mimeindustries/mearm-pi-hat-pcb/README.md

## MeArm Raspberry Pi HAT PCB

This repository contains the KiCAD project for the MeArm Raspberry Pi HAT
