mimeindustries/mearm-pi-hat-pcb/MeArmPiHat.kicad_pcb

## KiCad design MeArmPiHat.kicad_pcb (2017-10-23)

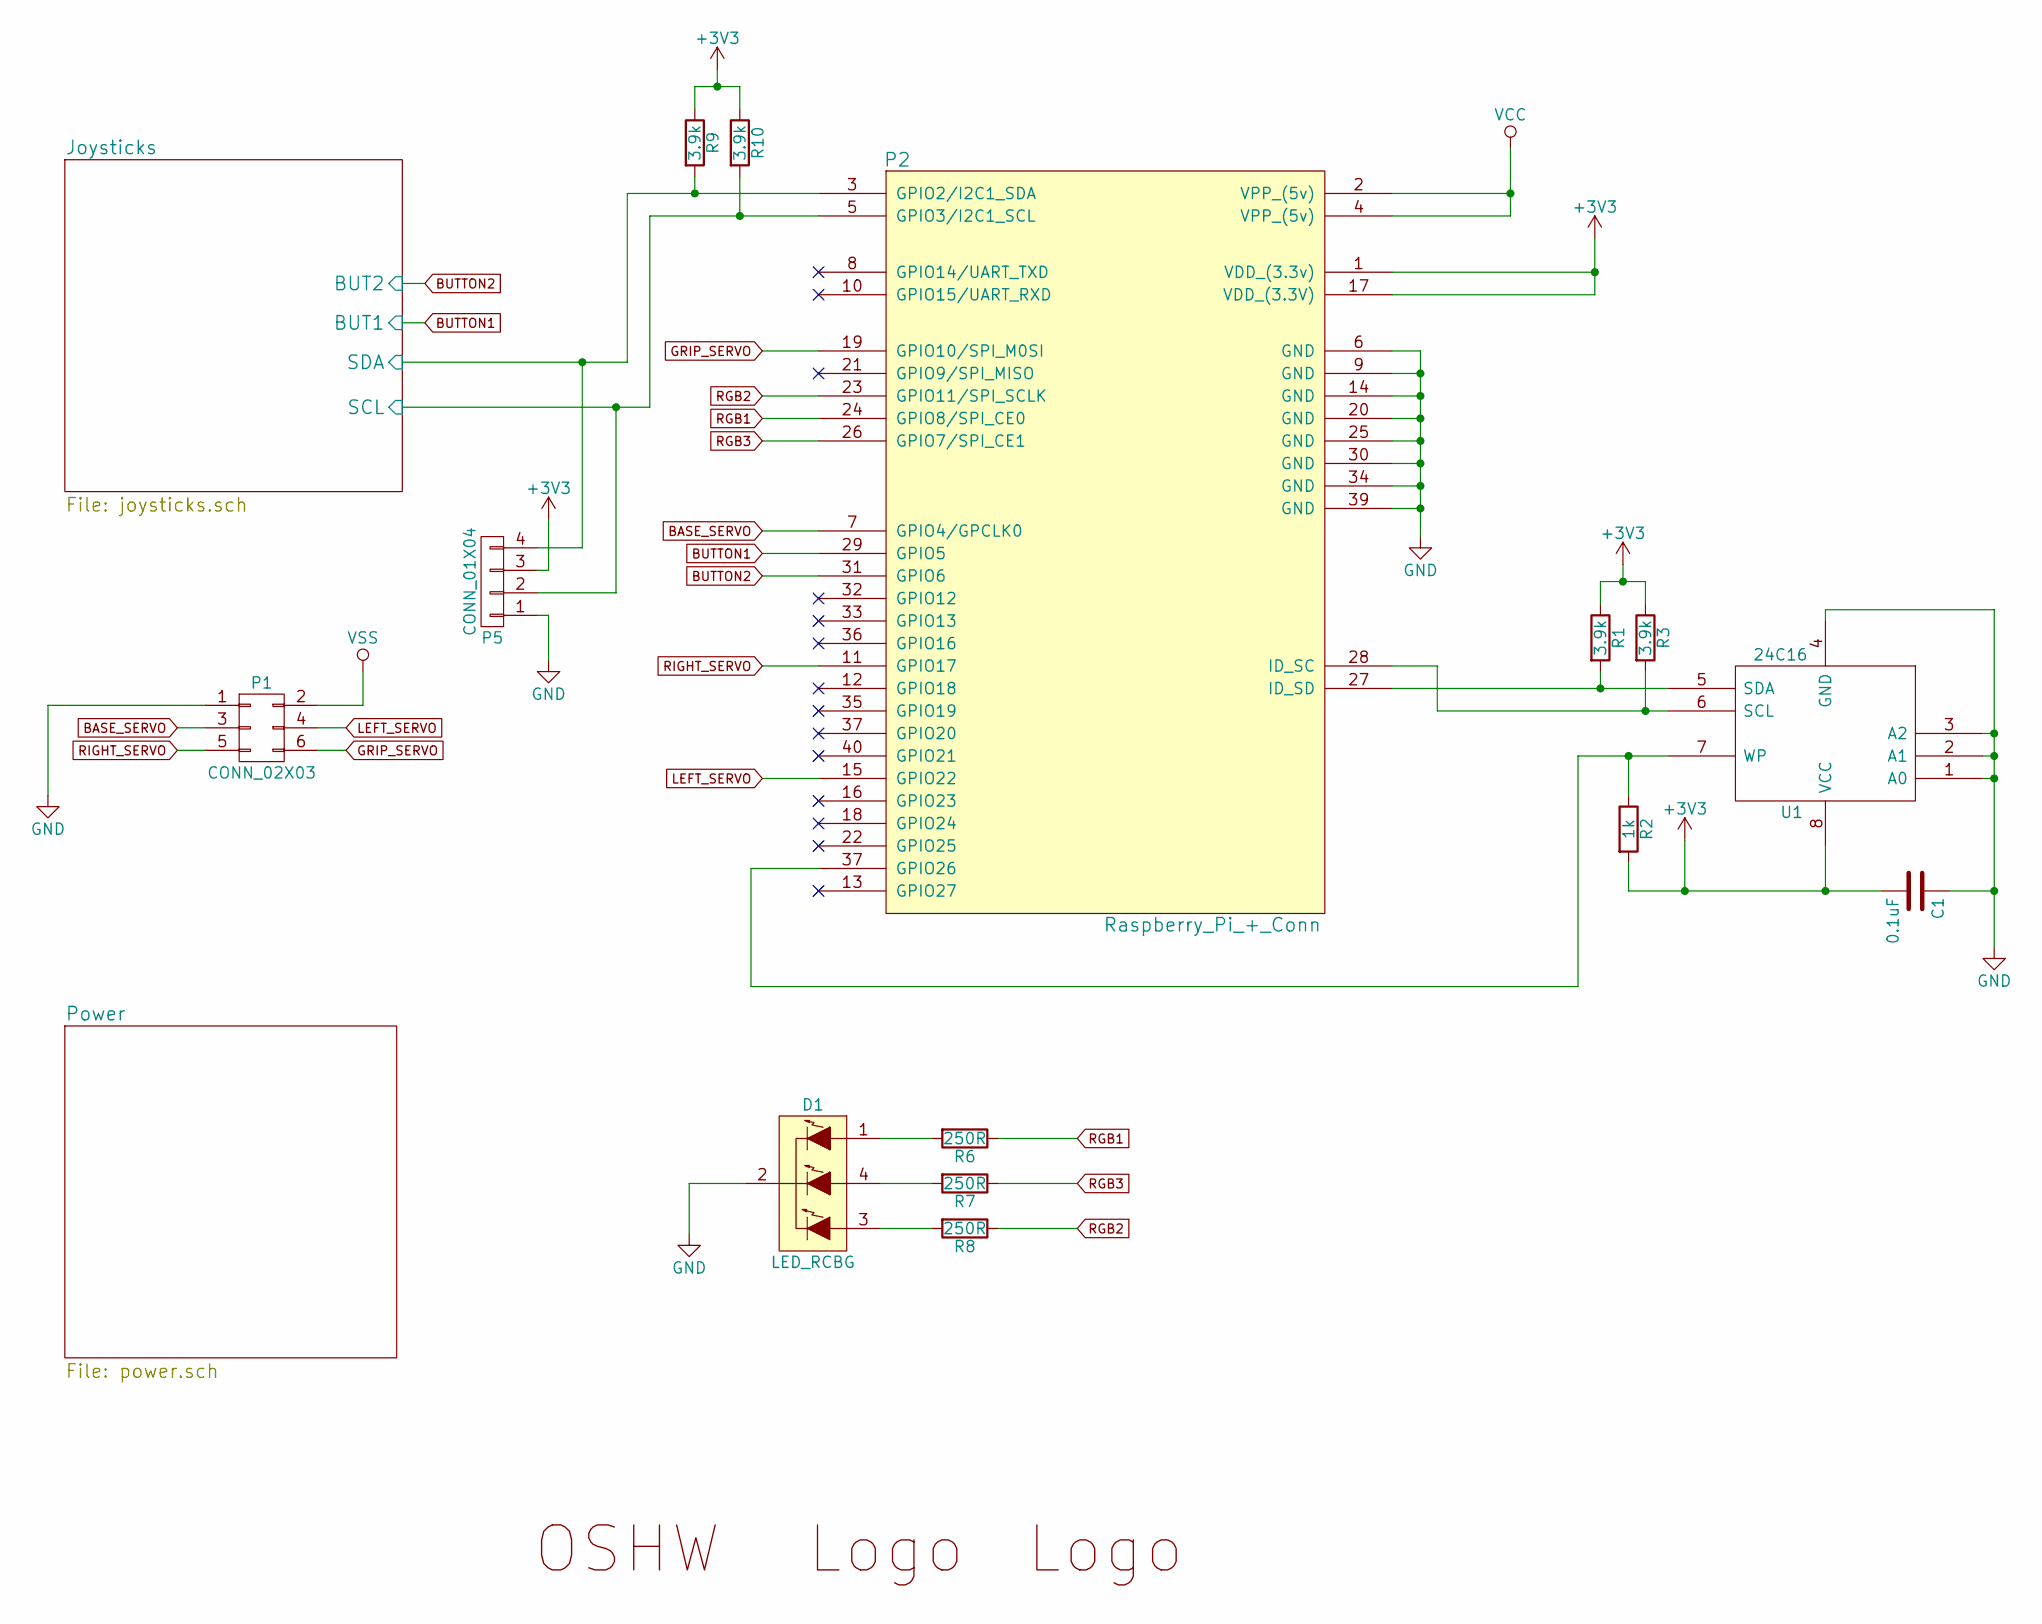
[picture p1: schematic MeArmPiHat.sch]

Parts:
ART1: OSHW-LOGO; OSHW_LOGO
ART2: LOGO; MEARM_LOGO_NEW_LARGE
ART3: LOGO; MIME_LOGO
C1: 0.1uF; C_0603
D1: LED_RCBG; LED-RGB-5MM_Common_Cathode
P1: CONN_02X03; Pin_Header_Straight_2x03
P2: Raspberry_Pi_+_Conn; 02x40-SMD-Socket-Flipped; Manfr. Part Number (MFP) REF-182665-01
P5: CONN_01X04; Pin_Header_Angled_1x04
R1, R3, R9, R10: 3.9k; R_0603
R2: 1k; R_0603
R6, R7, R8: 250R; R_0603
U1: 24C16; SOIC-8-N; Manfr. Part Number (MFP) CAT24C32WI

Connections:
+3V3: C1.2, P2.1 (VDD_(3.3v)), P2.17 (VDD_(3.3V)), P5.3, R1.1, R2.2, R3.1, R9.1, R10.1, U1.8 (VCC); also elsewhere on the board
/Joysticks/SCL: P2.5 (GPIO3/I2C1_SCL), P5.2, R10.2; also elsewhere on the board
/Joysticks/SDA: P2.3 (GPIO2/I2C1_SDA), P5.4, R9.2; also elsewhere on the board
BASE_SERVO: P1.3, P2.7 (GPIO4/GPCLK0)
BUTTON1: P2.29 (GPIO5); also elsewhere on the board
BUTTON2: P2.31 (GPIO6); also elsewhere on the board
GND: C1.1, D1.2 (COMMON_CATHODE), P1.1, P2.6 (GND), P2.9 (GND), P2.14 (GND), P2.20 (GND), P2.25 (GND), P2.30 (GND), P2.34 (GND), P2.39 (GND), P5.1, U1.1 (A0), U1.2 (A1), U1.3 (A2), U1.4 (GND); also elsewhere on the board
GRIP_SERVO: P1.6, P2.19 (GPIO10/SPI_M0SI)
LEFT_SERVO: P1.4, P2.15 (GPIO22)
unnamed: D1.1 (RED_ANODE), R6.2
unnamed: D1.3 (BLUE_ANODE), R8.2
unnamed: D1.4 (GREEN_ANODE), R7.2
unnamed: P2.27 (ID_SD), R1.2, U1.5 (SDA)
unnamed: P2.28 (ID_SC), R3.2, U1.6 (SCL)
unnamed: P2.37 (GPIO20), R2.1, U1.7 (WP)
RGB1: P2.24 (GPIO8/SPI_CE0), R6.1
RGB2: P2.23 (GPIO11/SPI_SCLK), R8.1
RGB3: P2.26 (GPIO7/SPI_CE1), R7.1
RIGHT_SERVO: P1.5, P2.11 (GPIO17)
VCC: P2.2 (VPP_(5v)), P2.4 (VPP_(5v)); also elsewhere on the board
VSS: P1.2; also elsewhere on the board

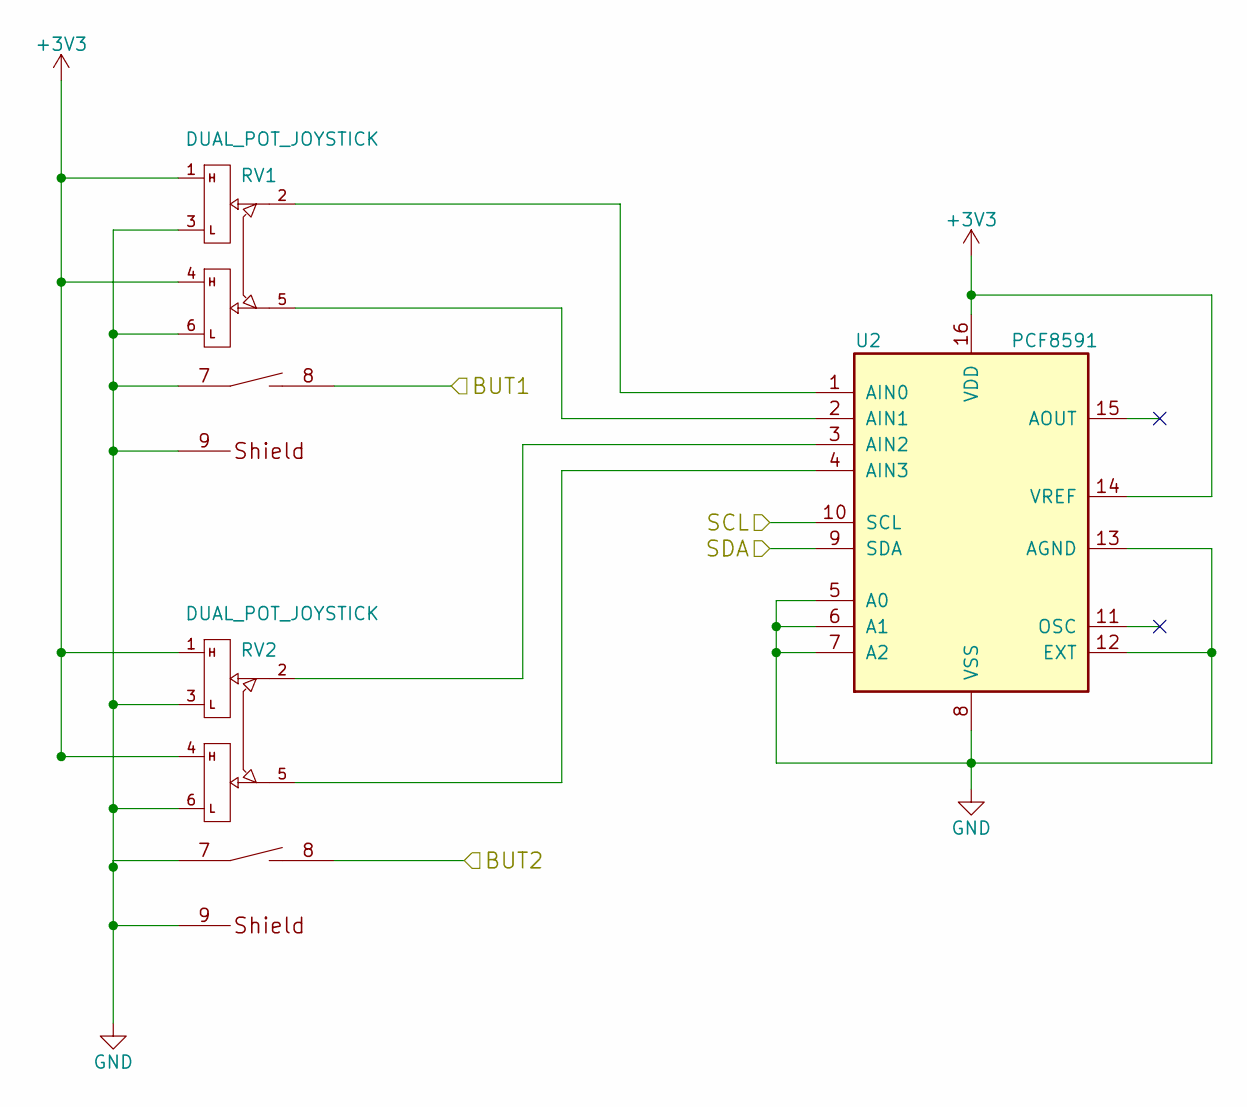
[picture p2: schematic joysticks.sch]

Parts:
RV1, RV2: DUAL_POT_JOYSTICK; JOYSTICK
U2: PCF8591; SO-16-W; Manfr. Part Number (MFP) PCF8591T

Connections:
+3V3: RV1.1, RV1.4, RV2.1, RV2.4, U2.14 (VREF), U2.16 (VDD); also elsewhere on the board
/Joysticks/SCL: U2.10 (SCL); also elsewhere on the board
/Joysticks/SDA: U2.9 (SDA); also elsewhere on the board
BUTTON1: RV1.8; also elsewhere on the board
BUTTON2: RV2.8; also elsewhere on the board
GND: RV1.3, RV1.6, RV1.7, RV1.9 (Shield), RV2.3, RV2.6, RV2.7, RV2.9 (Shield), U2.5 (A0), U2.6 (A1), U2.7 (A2), U2.8 (VSS), U2.12 (EXT), U2.13 (AGND); also elsewhere on the board
unnamed: RV1.2, U2.1 (AIN0)
unnamed: RV1.5, U2.2 (AIN1)
unnamed: RV2.2, U2.3 (AIN2)
unnamed: RV2.5, U2.4 (AIN3)

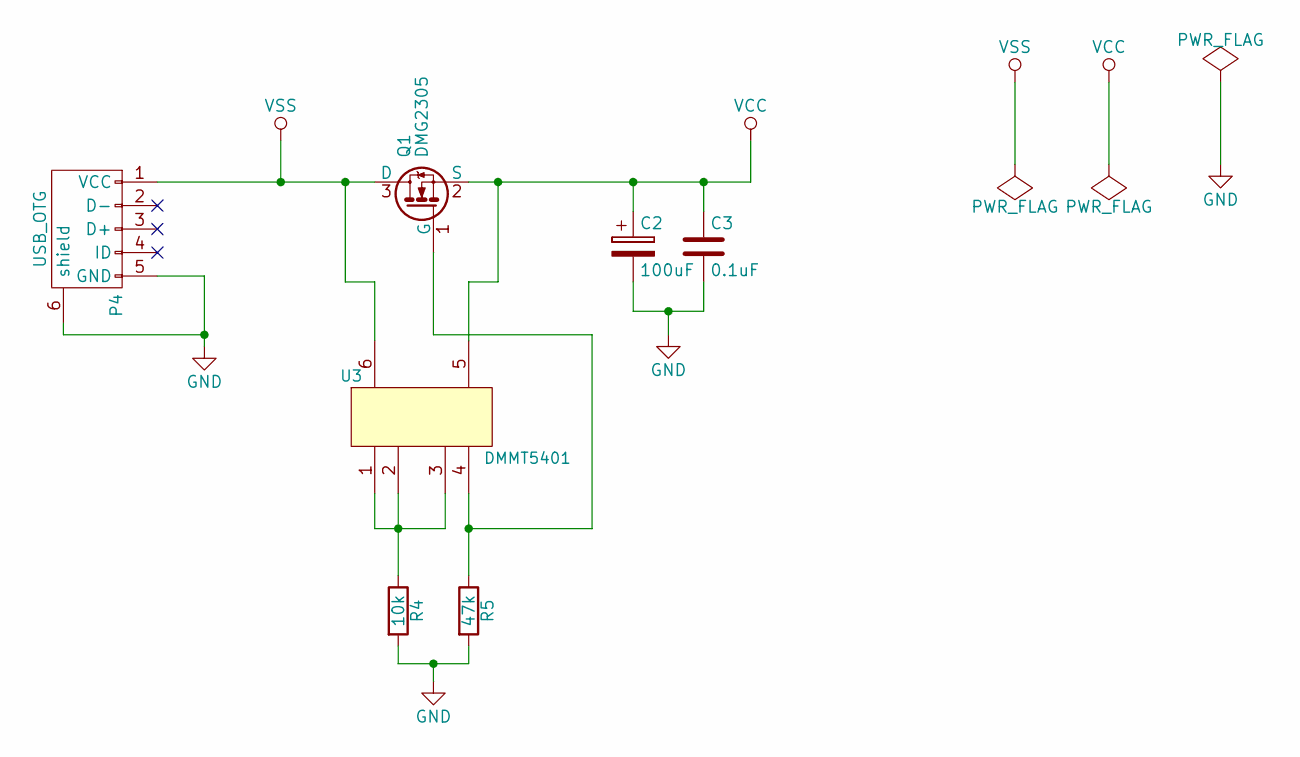
[picture p3: schematic power.sch]

Parts:
C2: 100uF; TantalC_SizeB_EIA-3528_Reflow
C3: 0.1uF; C_0603
P4: USB_OTG; AMPHENOL_MICRO_USB_REVERSED; Manfr. Part Number (MFP) 10103592-0001LF
Q1: DMG2305; SOT-23; Manfr. Part Number (MFP) DMG2305UX-7
R4: 10k; R_0603
R5: 47k; R_0603
U3: DMMT5401; SOT-23-6; Manfr. Part Number (MFP) DMMT5401-7-F

Connections:
GND: C2.2, C3.2, P4.5 (GND), P4.6 (shield), R4.2, R5.2; also elsewhere on the board
unnamed: Q1.1 (G), R5.1, U3.4
unnamed: R4.1, U3.1, U3.2, U3.3
VCC: C2.1, C3.1, Q1.2 (S), U3.5; also elsewhere on the board
VSS: P4.1 (VCC), Q1.3 (D), U3.6; also elsewhere on the board

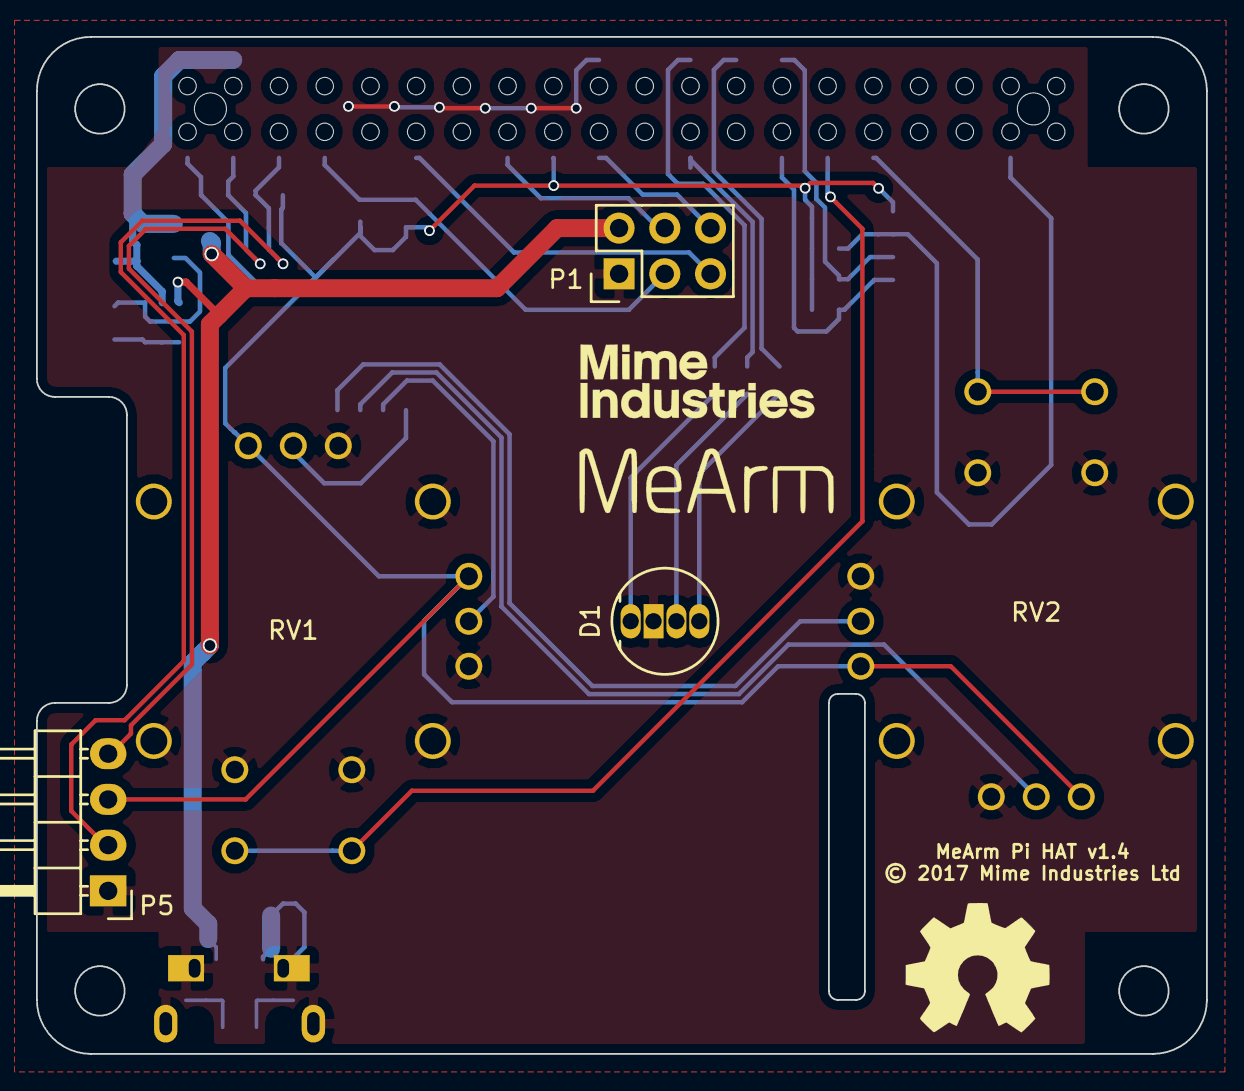
[picture p4: board MeArmPiHat.kicad_pcb from above]

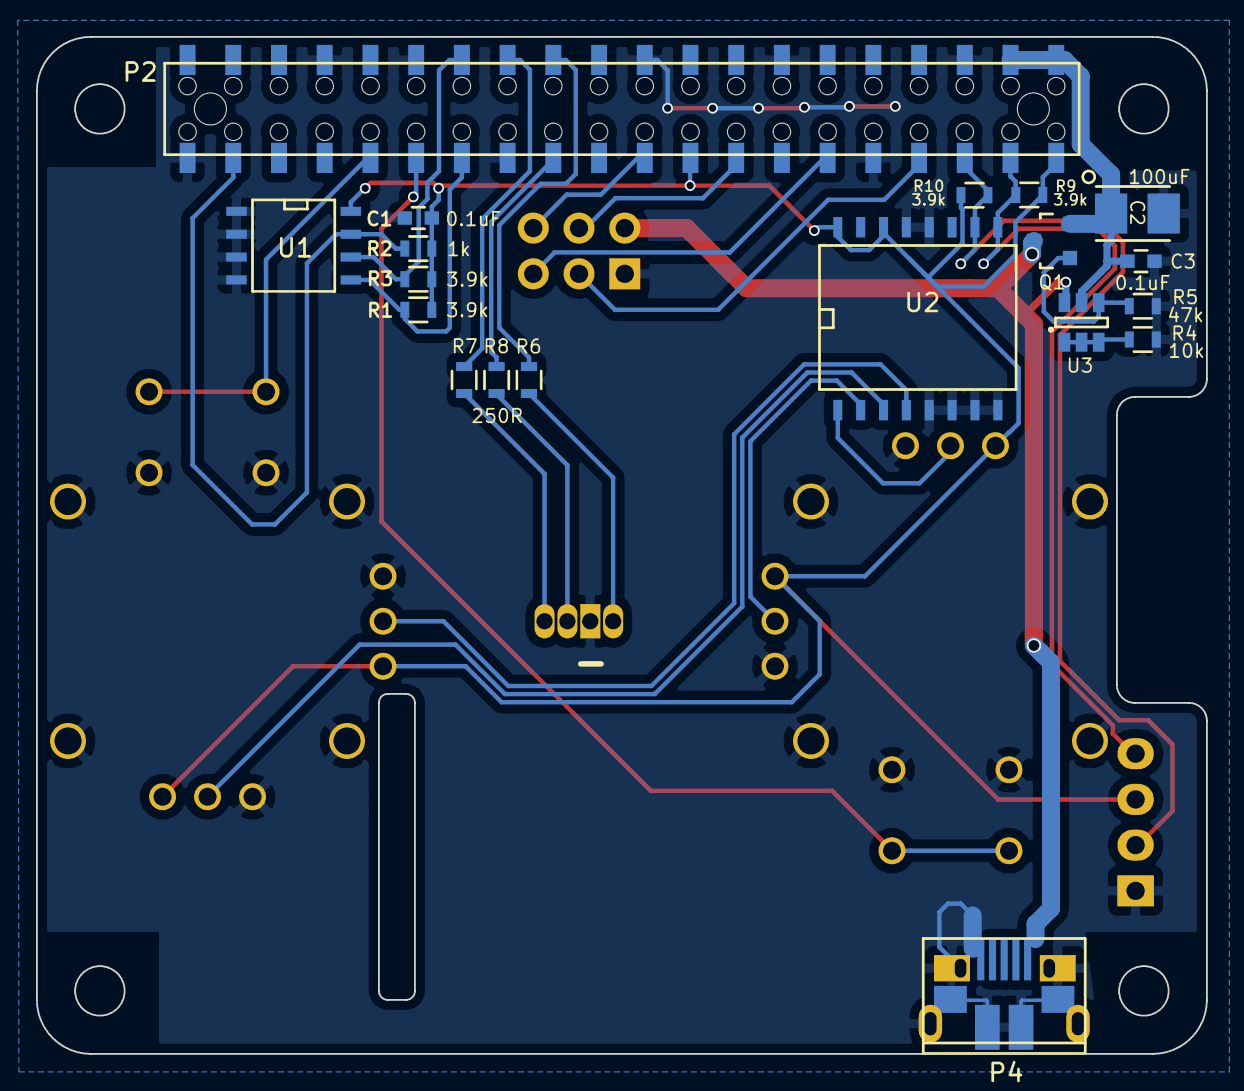
[picture p5: board MeArmPiHat.kicad_pcb from below]

Board: 2 copper layers, 65.0 x 56.5 mm, 27 parts (19 on the bottom side), 27 nets.
