mimeindustries/mearm-pi-hat-pcb/(notices)

Notices in the files:
MeArmPiHat.kicad_pcb:
© 2017 Mime Industries Ltd
